GReX-Telescope/FEM_Hardware/GreX Frontend.kicad_pcb

## KiCad design GreX Frontend.kicad_pcb (2022-04-11)

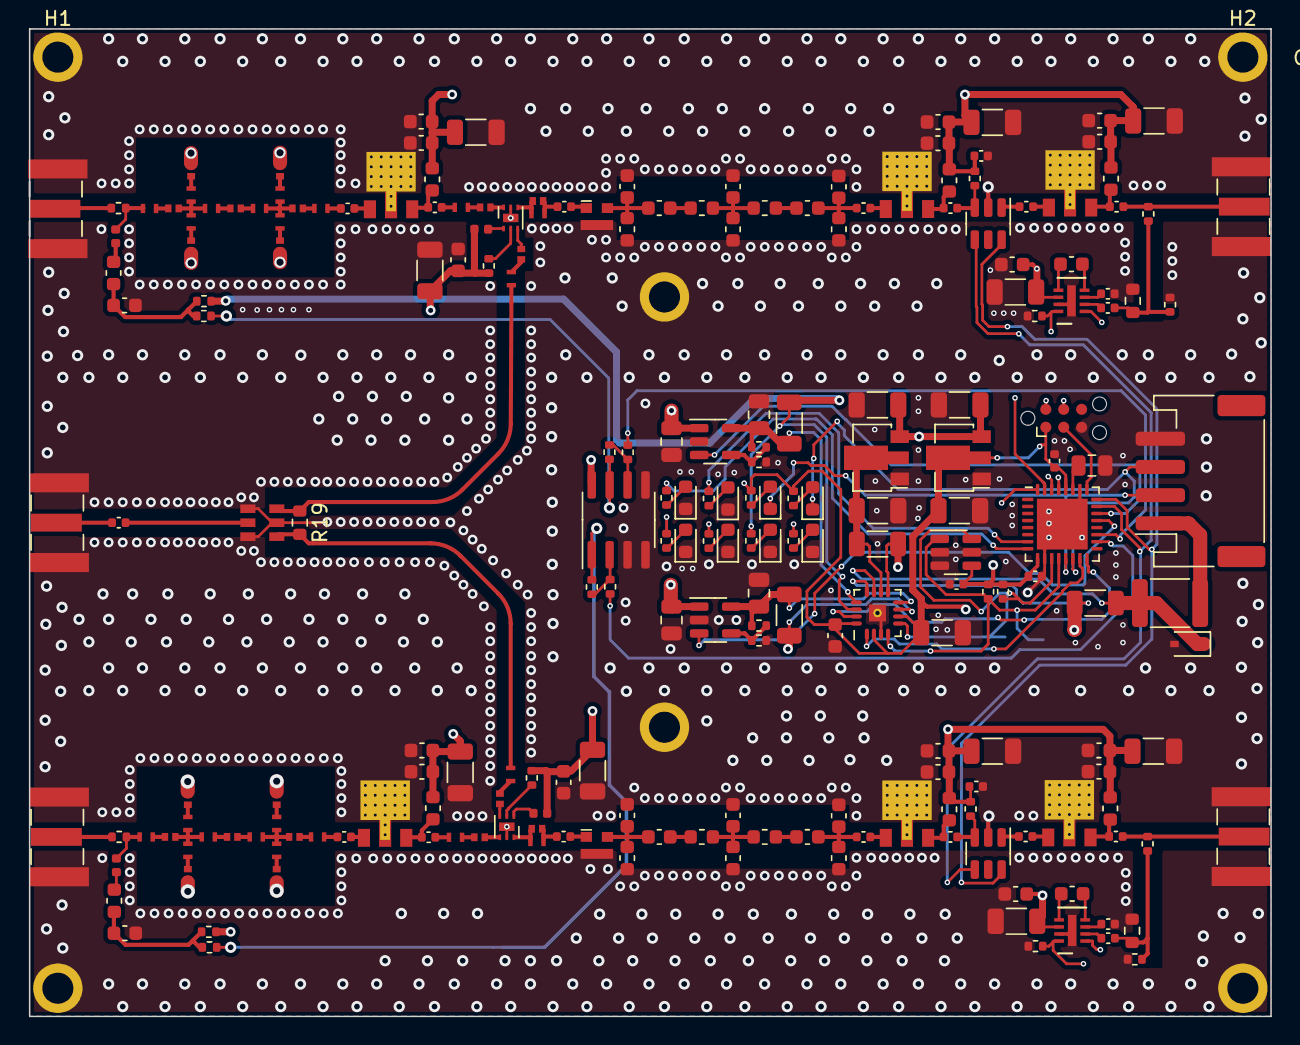
[picture p1: board GreX Frontend.kicad_pcb from above]

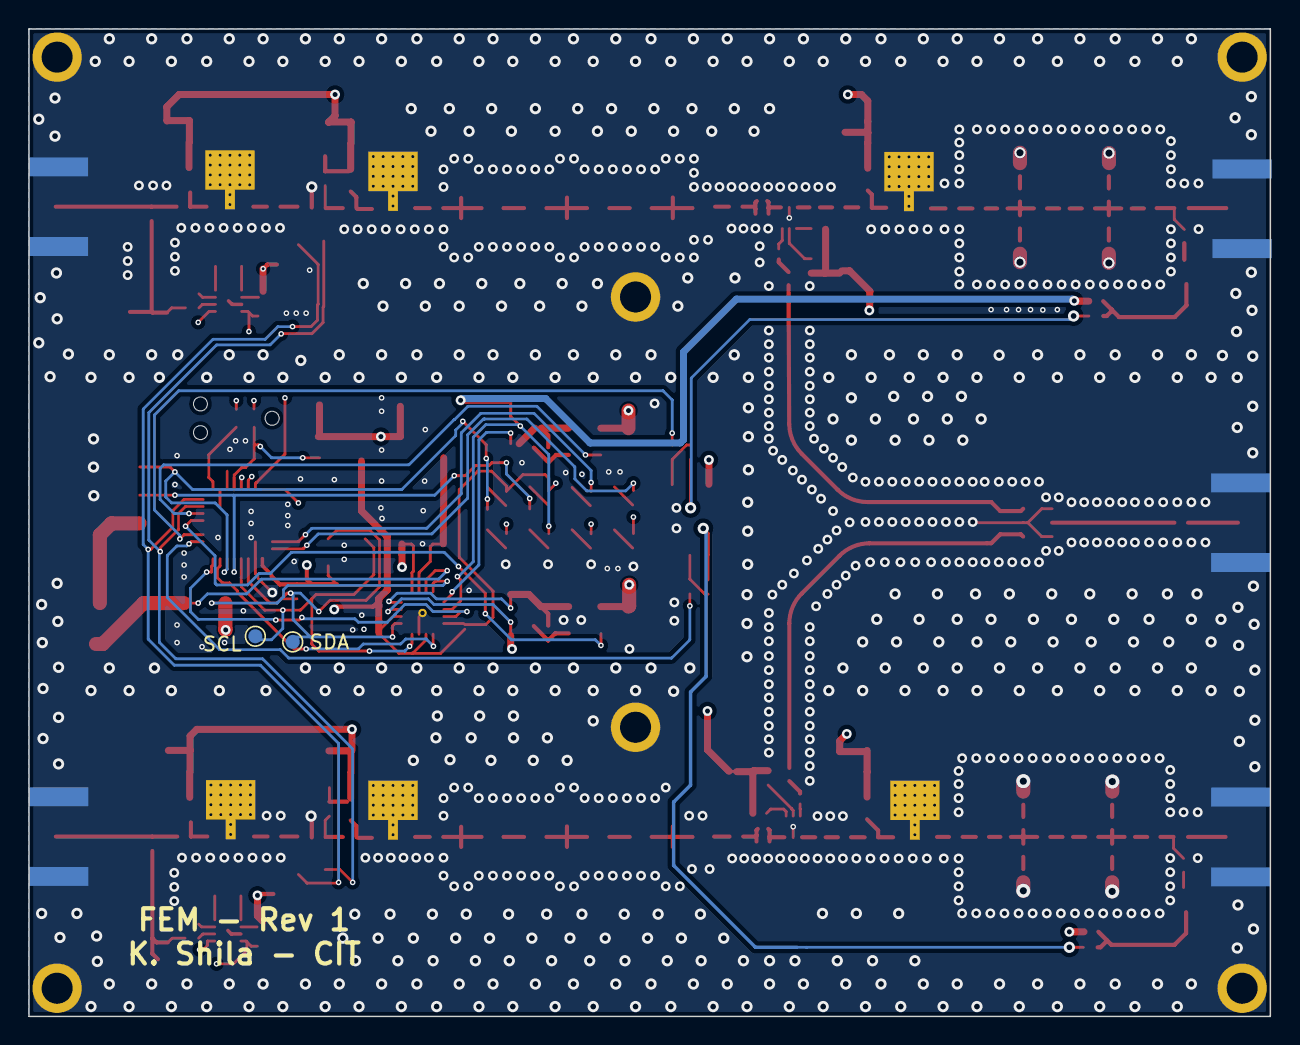
[picture p2: board GreX Frontend.kicad_pcb from below]

Board: 4 copper layers, 88.0 x 70.0 mm, 228 parts (2 on the bottom side), 137 nets.

Parts:
C1, C3, C15, C20, C36, C38, C43, C48: 100p; C_0603_1608Metric
C2, C16, C19, C34, C35, C44, C47, C49, C54, C63, C66: 100n; C_0402_1005Metric
C4, C7, C37, C39, C42, C56, C57, C59, C68, C69, C95, C96, C99: 100p; C_0402_1005Metric
C5, C17, C22, C32, C40, C45, C51, C52, C64, C93, C98: 1n; C_0603_1608Metric
C6, C18, C21, C25, C26, C27, C28, C31, C41, C46, C50, C53, C65, C94, C97: 10u; C_1206_3216Metric
C8, C14, C75, C81: 0.9p; C_0402_MDLX
C9, C12, C76, C79: 0.43p; C_0402_MDLX
C10, C13, C77, C80: 4.3p; C_0402_MDLX
C11, C78: 0.25p; C_0402_MDLX
C23, C24, C29, C30, C33: 1u; C_0805_2012Metric
C55, C67: 33n; C_0603_1608Metric
C70, C74, C82, C86: 18p; C_0603_1608Metric
C71, C73, C83, C85: 4.3p; C_0603_1608Metric
C72, C84: 33p; C_0603_1608Metric
C87, C88: 33p; C_0402_MDLX
C89, C90, C91, C92: 3.3p; C_0402_MDLX
D1, D2, D3, D4: RED; LED_0603_1608Metric
D5, D6: GREEN; LED_0603_1608Metric
D7, D8: BLUE; LED_0603_1608Metric
D9: D_Schottky; D_SOD-323
F1: Polyfuse; Fuse_1812_4532Metric
FB1, FB2: FerriteBead_Small; L_0603_1608Metric
H1, H2, H3, H4, H5, H6: MountingHole_2.2mm_M2_ISO7380_Pad
J1, J2, J5, J6, J7: Conn_Coaxial; SMA_Samtec_SMA-J-P-X-ST-EM1_EdgeMount
J3: Screw_Terminal_01x04; JST_PH_S4B-PH-SM4-TB_1x04-1MP_P2.00mm_Horizontal
J4: PROG; Tag-Connect_TC2030-IDC-NL_2x03_P1.27mm_Vertical
L2, L7: 82n; L_0402_1005Metric
L3, L8: 100n; L_0603_1608Metric
L4, L17, L25, L32: 9.9n; L_0402_MDLX
L5, L15, L26, L30: 8.2n; L_0402_MDLX
L9, L10, L18, L19: 1000n; L_0603_1608Metric
L12, L16, L27, L31: 7.1n; L_0402_MDLX
L13, L14, L28, L29: 16n; L_0402_MDLX
L20, L24, L33, L37: 9.1n; L_0603_1608Metric
L21, L23, L34, L36: 43n; L_0603_1608Metric
L22, L35: 5.6n; L_0603_1608Metric
L38, L39: 5.6n; L_0402_MDLX
L40, L41: 4.3n; L_0402_MDLX
L42, L43: 4.7n; L_0402_MDLX
L44, L45: 33n; L_0402_1005Metric
R1, R16, R26, R27, R28, R29: 0; R_0402_1005Metric
R2, R17: 33k; R_0402_1005Metric
R3, R18: 49.9; R_0603_1608Metric
R4, R5: 0.1; R_1206_3216Metric
R6, R7: 0.5; R_1206_3216Metric
R8, R9, R10, R11, R12, R13, R14, R15, R20, R21: 1k; R_0402_1005Metric
R19: 100; R_0603_1608Metric
R22, R23: 10k; R_0402_1005Metric
R24, R25: 20k; R_0402_1005Metric
R30, R32: 42.2k; R_0402_1005Metric
R31, R33: 12.4k; R_0402_1005Metric
R34, R35, R40, R41: 4.7k; R_0402_1005Metric
R36, R38: 226; R_0402_1005Metric
R37, R39: 61.9; R_0402_1005Metric
TP1, TP2: TestPoint; TestPoint_Pad_D1.0mm
U1, U5, U7, U15, U18, U20: ADL5545
U2, U3: GRF7001; DFN6-1.5mm-EP0.6x1.1
U4, U17: PAT1220-C-3DB; RF_Attenuator_Susumu_PAT1220
U6, U19: HMC291SE; SOT-23-6
U8, U21: LT5537; DFN-8-1EP_2x3mm_P0.5mm_EP0.61x2.2mm
U9: AZ1117-3.3; SOT-89-3
U10: AZ1117-5.0; SOT-89-3
U11, U12: SPX5205M5-L; SOT-23-5
U13: PAC1944; QFN-16_EP_3x3_Pitch0.5mm
U14: ATSAMD21E17L-M; QFN-32-1EP_5x5mm_P0.5mm_EP3.6x3.6mm
U16: TMP100; SOT-23-6
U24: SCN-2-11; FV1206-1
U25: RC4558; SOIC-8_3.9x4.9mm_P1.27mm

Connections:
+3V3: C2.1, C27.2, C31.2, C32.2, C34.1, C35.1, J4.1, R8.1, R14.1, R15.1, R34.1, R35.1, U9.2 (VO), U13.2 (Vdd), U13.6 (ADRSEL), U13.16 (~PWRDN), U14.9 (VDDIO/VDDANA), U14.28 (VDDIO), U16.4 (V+)
/RF/Input Stage 1/32_kHz: R20.2, R27.1, U25.7
/RF/Input Stage 1/Image Reject Filter1/1: L2.1, L4.1, R1.2
/RF/Input Stage 1/Image Reject Filter1/2: C4.1, L17.2
/RF/Input Stage 1/OUT: C7.2, L40.1
/RF/Input Stage 2/32_kHz: R21.2, R29.1, U25.1
/RF/Input Stage 2/Image Reject Filter1/1: L7.1, L25.1, R16.2
/RF/Input Stage 2/Image Reject Filter1/2: C39.1, L32.2
/RF/Input Stage 2/OUT: C42.2, L41.1
/RF/Output Stage 1/IF Filter1/In: C70.2, C71.2, L20.1, U4.2
/RF/Output Stage 1/IF Filter1/Out: C16.1, C73.1, C74.2, L24.1
/RF/Output Stage 1/In: C95.2, U4.1
/RF/Output Stage 2/IF Filter1/In: C82.2, C83.2, L33.1, U17.2
/RF/Output Stage 2/IF Filter1/Out: C44.1, C85.1, C86.2, L37.1
/RF/Output Stage 2/In: C96.2, U17.1
ALERT1: U13.1 (~ALERT), U14.15 (PA14)
ALERT2: U13.15 (~ALERT2), U14.16 (PA15)
ATTEN_V1: U6.4 (V1), U14.23 (PA24), U19.4 (V1)
ATTEN_V2: U6.6 (V2), U14.24 (PA25), U19.6 (V2)
GND: C1.1, C2.2, C3.1, C5.1, C6.1, C9.2, C10.1, C12.2, C13.1, C15.1, C17.1, C18.1, C20.1, C21.1, C22.1, C23.2, C24.2, C25.1, C26.1, C27.1, C28.1, C29.2, C30.2, C31.1, C32.1, C33.2, C34.2, C35.2, C36.1, C37.2, C38.1, C40.1, C41.1, C43.1, C45.1, C46.1, C48.1, C50.1, C51.1, C52.1, C53.1, C57.2, C64.1, C65.1, C69.2, C70.1, C72.1, C74.1, C76.2, C77.1, C79.2, C80.1, C82.1, C84.1, C86.1, C93.1, C94.1, C97.1, C98.1, C99.2, D1.1 (K), D2.1 (K), D3.1 (K), D4.1 (K), D5.1 (K), D6.1 (K), D9.2 (A), H1.1, H2.1, H3.1, H4.1, H5.1, H6.1, J1.2 (Ext), J2.2 (Ext), J3.4, J4.5, J5.2 (Ext), J6.2 (Ext), J7.2 (Ext), L20.2, L22.2, L24.2, L33.2, L35.2, L37.2, R2.2, R3.1, R17.2, R18.1, R31.2, R33.2, R37.2, R39.2, U1.2 (GND), U2.5 (GND), U2.EP (GND), U3.5 (GND), U3.EP (GND), U4.3, U5.2 (GND), U6.2 (GND), U7.2 (GND), U8.7 (GND), U8.9 (EP), U9.1 (GND), U10.1 (GND), U11.2 (GND), U12.2 (GND), U13.3 (GND), U13.17 (EP), U14.10 (GND), U14.26 (GND), U14.33 (EP), U15.2 (GND), U16.2 (GND), U16.3 (ADD1), U16.5 (ADD0), U17.3, U18.2 (GND), U19.2 (GND), U20.2 (GND), U21.7 (GND), U21.9 (EP), U24.1 (GND), U24.3 (GND), U24.5 (GND), U25.3 (+), U25.4 (V-), U25.5 (+)
unnamed: C1.2, FB1.2, R26.2, R27.2
unnamed: C4.2, U1.1
unnamed: C7.1, L3.2, U1.3
unnamed: C8.1, L4.2
unnamed: C8.2, L5.1, L12.2, L13.1
unnamed: C9.1, L5.2
unnamed: C10.2, L12.1
unnamed: C11.1, L13.2
unnamed: C11.2, L14.1
unnamed: C12.1, L15.2
unnamed: C13.2, L16.1
unnamed: C14.1, L14.2, L15.1, L16.2
unnamed: C14.2, L17.1
unnamed: C16.2, U5.1
unnamed: C19.1, L18.2, U5.3
unnamed: C19.2, R40.2, U6.3 (RF1)
unnamed: C33.1, U14.27 (VDDCORE)
unnamed: C36.2, FB2.2, R28.2, R29.2
unnamed: C39.2, U15.1
unnamed: C42.1, L8.2, U15.3
unnamed: C44.2, U18.1
unnamed: C47.1, L9.2, U18.3
unnamed: C47.2, R41.2, U19.3 (RF1)
unnamed: C49.1, U19.1 (RF2)
unnamed: C49.2, U20.1
unnamed: C54.1, L10.2, U20.3
unnamed: C54.2, J6.1 (In), R38.1
unnamed: C55.1, U21.5 (CAP-)
unnamed: C55.2, U21.4 (CAP+)
unnamed: C56.1, U21.2 (IN+)
unnamed: C56.2, R18.2, R38.2, R39.1
unnamed: C57.1, U21.3 (IN-)
unnamed: C59.1, J7.1 (In)
unnamed: C59.2, U24.2 (IN)
unnamed: C63.1, U6.1 (RF2)
unnamed: C63.2, U7.1
unnamed: C66.1, L19.2, U7.3
unnamed: C66.2, J2.1 (In), R36.1
unnamed: C67.1, U8.5 (CAP-)
unnamed: C67.2, U8.4 (CAP+)
unnamed: C68.1, U8.2 (IN+)
unnamed: C68.2, R3.2, R36.2, R37.1
unnamed: C69.1, U8.3 (IN-)
unnamed: C71.1, L21.1
unnamed: C72.2, L21.2, L22.1, L23.1
unnamed: C73.2, L23.2
unnamed: C75.1, L25.2
unnamed: C75.2, L26.1, L27.2, L28.1
unnamed: C76.1, L26.2
unnamed: C77.2, L27.1
unnamed: C78.1, L28.2
unnamed: C78.2, L29.1
unnamed: C79.1, L30.2
unnamed: C80.2, L31.1
unnamed: C81.1, L29.2, L30.1, L31.2
unnamed: C81.2, L32.1
unnamed: C83.1, L34.1
unnamed: C84.2, L34.2, L35.1, L36.1
unnamed: C85.2, L36.2
unnamed: C87.1, L38.2
unnamed: C87.2, U2.3 (LO)
unnamed: C88.1, L39.2
unnamed: C88.2, U3.3 (LO)
unnamed: C89.1, L40.2
unnamed: C89.2, U2.6 (RF/IF)
unnamed: C90.1, L41.2
unnamed: C90.2, U3.4 (RF/IF)
unnamed: C91.1, L42.1, U2.4 (RF/IF)
unnamed: C91.2, C95.1, L42.2
unnamed: C92.1, L43.1, U3.6 (RF/IF)
unnamed: C92.2, C96.1, L43.2
unnamed: D1.2 (A), R8.2
unnamed: D2.2 (A), R9.2
unnamed: D3.2 (A), R10.2
unnamed: D4.2 (A), R11.2
unnamed: D5.2 (A), R12.2
unnamed: D6.2 (A), R13.2
unnamed: D7.2 (A), R14.2
unnamed: D8.2 (A), R15.2
unnamed: F1.1, J3.1
unnamed: FB1.1, L2.2
unnamed: FB2.1, L7.2
unnamed: J1.1 (In), R1.1
unnamed: J5.1 (In), R16.1
unnamed: L38.1, R19.1, U24.6 (OUT_1)
unnamed: L39.1, R19.2, U24.4 (OUT_2)
unnamed: L44.1, U2.1 (VDD)
unnamed: L45.1, U3.1 (VDD)
unnamed: R20.1, R22.2, U25.6 (-)
unnamed: R21.1, R23.2, U25.2 (-)
unnamed: R24.1, U2.2 (V_EN)
unnamed: R25.2, U3.2 (V_EN)
unnamed: R30.2, R31.1, U11.4 (ADJ)
unnamed: R32.2, R33.1, U12.4 (ADJ)
RF1_32kHz: R22.1, U14.19 (PA18)
RF1_IF_POW: R2.1, U8.8 (OUT), U14.31 (PB02)
RF1_LNA_EN: U11.3 (EN), U14.22 (PA23)
RF1_STATUS_LED: R12.1, U14.8 (PA07)
RF2_32kHz: R23.1, U14.18 (PA17)
RF2_IF_POW: R17.1, U14.32 (PB03), U21.8 (OUT)
RF2_LNA_EN: U12.3 (EN), U14.21 (PA22)
RF2_STATUS_LED: R13.1, U14.7 (PA06)
RXD: D8.1 (K), J3.3, U14.14 (PA11)
SCL: R35.2, TP2.1, U13.4 (SCL), U14.12 (PA09), U16.1 (SCL)
SDA: R34.2, TP1.1, U13.5 (SDA), U14.11 (PA08), U16.6 (SDA)
SWCLK: J4.4, U14.29 (PA30)
SWDIO: J4.2, U14.30 (PA31)
TXD: D7.1 (K), J3.2, U14.13 (PA10)
VA_+: C28.2, R5.1, U10.2 (VO), U13.10 (SENSE4+)
VA_-: C3.2, C5.2, C6.2, C15.2, C17.2, C18.2, C20.2, C21.2, C22.2, C37.1, C38.2, C40.2, C41.2, C43.2, C45.2, C46.2, C48.2, C50.2, C51.2, C52.2, C53.2, C64.2, C65.2, C93.2, C94.2, C97.2, C98.2, C99.1, L3.1, L8.1, L9.1, L10.1, L18.1, L19.1, L44.2, L45.2, R5.2, R9.1, R24.2, R25.1, R40.1, R41.1, U8.1 (ENBL), U8.6 (VCC), U13.9 (SENSE4-), U21.1 (ENBL), U21.6 (VCC), U25.8 (V+)
VIN_+: D9.1 (K), F1.2, R4.1, U13.11 (SENSE1+)
VIN_-: C23.1, C24.1, C25.2, C26.2, R4.2, U9.3 (VI), U10.3 (VI), U11.1 (IN), U12.1 (IN), U13.12 (SENSE1-)
VLNA1_+: C29.1, R6.1, R30.1, U11.5 (OUT), U13.13 (SENSE2+)
VLNA1_-: R6.2, R10.1, R26.1, U13.14 (SENSE2-)
VLNA2_+: C30.1, R7.1, R32.1, U12.5 (OUT), U13.8 (SENSE3+)
VLNA2_-: R7.2, R11.1, R28.1, U13.7 (SENSE3-)
nRESET: J4.3, U14.25 (~RESET)
